fgnievinski/mphw/docs/poster_pre_revisao7b.pdf

Manuella Anaís Rodrigues Fagundes ¹ and Felipe Geremia Nievinski

1,2

1 Postgraduate Program on Remote Sensing, State Research Center for Remote Sensing and Meteorology, Federal University of Rio Grande do Sul, Brazil 2 Department of Geodesy, Institute of Geosciences, Federal University of Rio Grande do Sul, Brazil manuella.fagundes@ufrgs.br;felipe.nievinski@ufrgs.br
1. Introduction | 2. Materials and methods

## 3. Field validation

# Open-source hardware options for SNR-based GPS/GNSS reflectometry – Proof-of-concept and initial validation

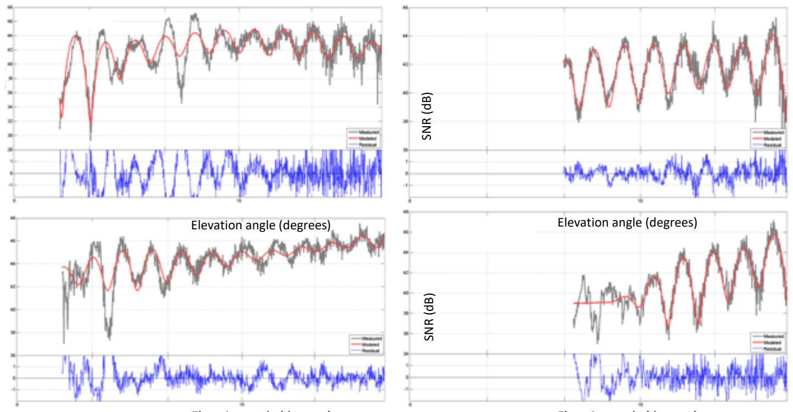
[picture p2: figure]
Elevation angle degree; SNR (dB) SNR (dB)

### 3.1 Location

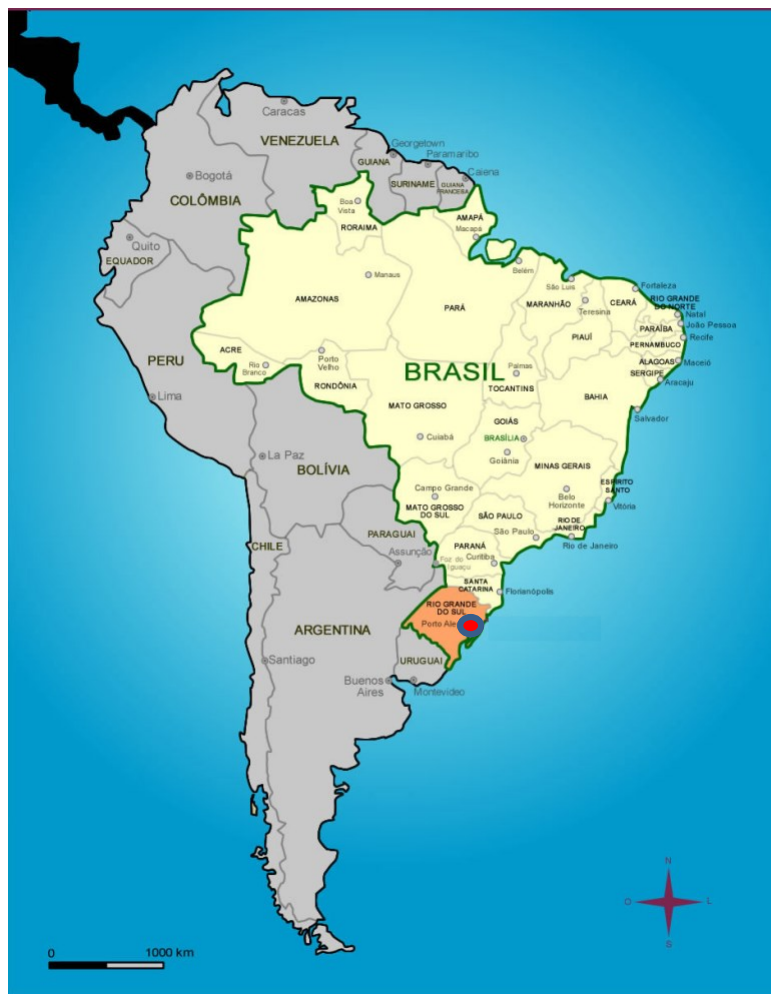
[picture p3: figure]
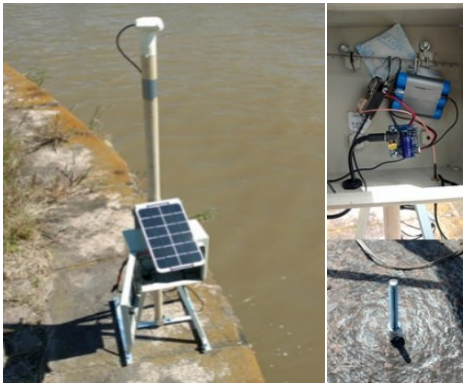
[picture p4: figure]
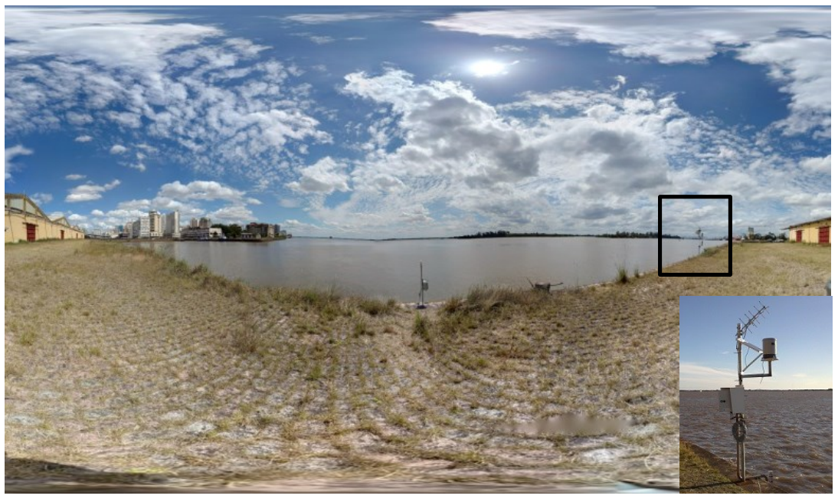
[picture p5: figure]
Figure 12: Localization
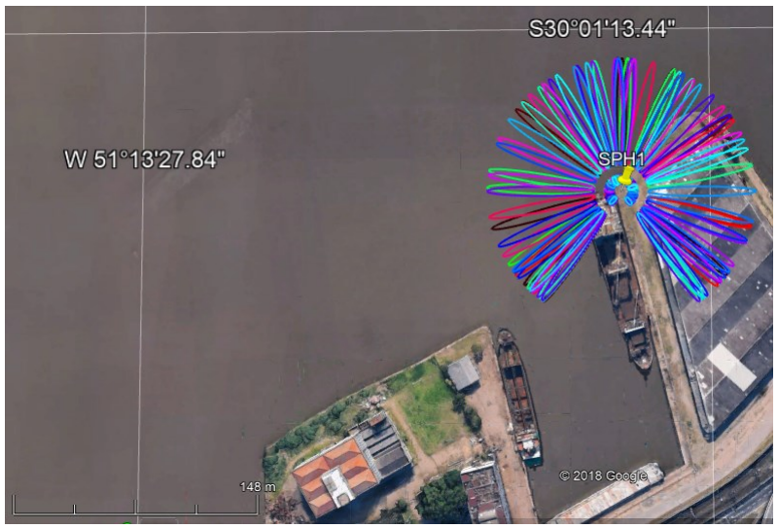
[picture p6: figure]
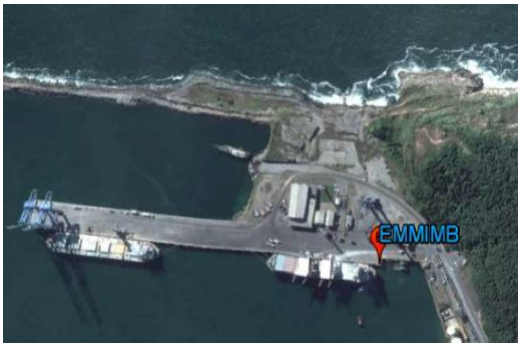
[picture p7: figure]
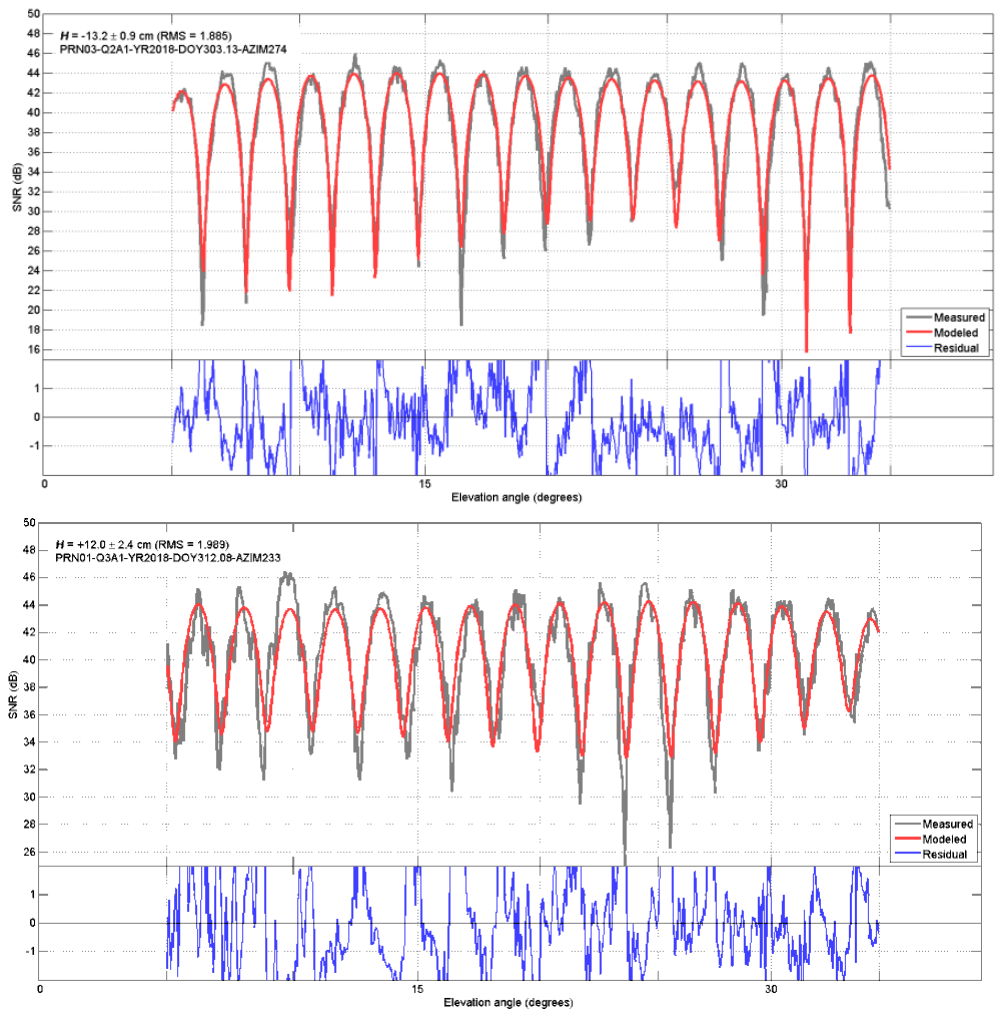
[picture p8: figure]

IEEE GNSS+R 2019 – Specialist Meeting on Reflectometry using GNSS and other Signals of Opportunity ∙ 20-22 May 2019, Benevento, Italy.

The | main | electronic | components
employed are shown in Figure 7: an Arduino board integrated with SD card
reader/writer | (Adafruit | Feather
Adalogger), a single-frequency GPS L1 C/A add-on (Adafruit GPS FeatherWing), and an external GPS antenna (active 28-dB, Chang Hong GPS-01-174-1M-0102). A complete solar power system was also developed (Figure 8).

Figure 7: Main sensor components: Arduino device with integrated SD-card interface (left); GPS shield with internal GPS antenna (middle); external antenna (right).

Figure 8: Solar power system: solar panel (far left); solar charge (center left); battery (center right); thermistor (far
right).

The total cost is US$205 as of January 2019; the complete bill of materials is publicly available at: http://www.adafruit.com/wishlists/469752

2.1 Hardware | 2.2 Software

We have developed two pieces of software, both available as open source. One piece runs onboard the Arduino and another runs in Matlab on a PC. They can be download from GitHub, at https://git.io/fjCnp.

Acknowledgements:

Figure 9: Sample SNR data in NMEA format.

On October 26th
, 2018 a unit was installed at the Mauá Wharf by the Guaíba River in the city of Porto Alegre, Brazil (30.0277°S, 51.2287°W), shown in Figures 11 and 12.

### 3.2 Installation

## 4. Initial results

We performed
inversion for the
estimation of the
water surface
height at the Mauá
Wharf applied to
several satellite
tracks (Figure 15).

Parameter estimates for the six satellite tracks shown resulted in a mean reflector height of 3.191 m with a standard deviation of 20 cm. For validation, we surveyed the water level and the antenna phase center, resulting in an average of 3.128 m with standard deviation of 2.4 cm, mainly caused by the small waves. The discrepancy of 6.3 cm amounts to approximately 2% of the reflector height.

Figure 1: Rising sea leve (left) and consequences (right).

Figure 2: Satellite altimeres (left) and tide gauge with GNSS.

Figure 3: Principles of the GNSS-R technique.

Figure 4: Applications of GNSS-R .

Figure 5: Geodetic equipment. | Figure 6: Experimental device.

Figure 10: Skyplot (left) and pattern of interference fringes (right)

Figure 13: GNSS-R experimental station.

Figure 14: Reflection Fresnel zones for elevation angles between 5° – 30° and antenna height equal to 3 m.

Figure 15: Inversion results: measurements are in gray, model fit in red, and residuals in blue (bottom panels).

Monitoring the sea level is fundamental due to climate change (Figure 1). Unfortunately, satellite altimeters do not work well in coastal regions and tide gauges are not as numerous as necessary and may be affected by vertical land motion (Figure 2).

Ground-based GNSS Reflectometry allows geocentric sea-level sensing (Figures 3 and 4). Geodetic-quality receivers and antennas are expensive; here, a lower-cost and open-source hardware alternative is presented (Figures 5 and 6).

Figure 12: Site panoramic view; inset: existing tide gauge.

Our GNSS-R station has been running uninterruptedly for more than six months (Figure 13).

## 5. Ongoing and future work

This research is funded by CNPq (457530/2014-6) and Fapergs (26228.414.42497.26062017).

MF acknowledges CAPES for a scholarship and IEEE for a travel grant.

Elevation angle (degrees)

Elevation angle (degrees)

Elevation angle (degrees) | Elevation angle (degrees)

We are in the process of analyzing several months of data collected since installation.

We | are | also | planning | an
installation by the sea, at the Imbituba Port (Santa Catarina state), where several tide gauges exist.

Figure 11: Map indicating the site location (red dot).

Figure 17: Location of future sea-facing installation.

Figure 16: Sample SNR results from river-facing site.
