fgnievinski/mphw/code/matlab/battery/battery_example.png

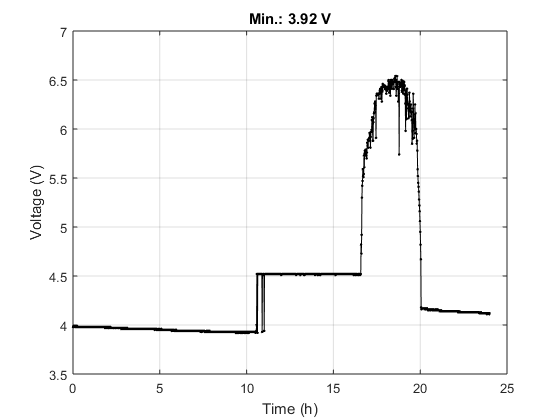
code/matlab/battery/battery_example.png
