fgnievinski/mphw/code/matlab/demo/PRN03.png

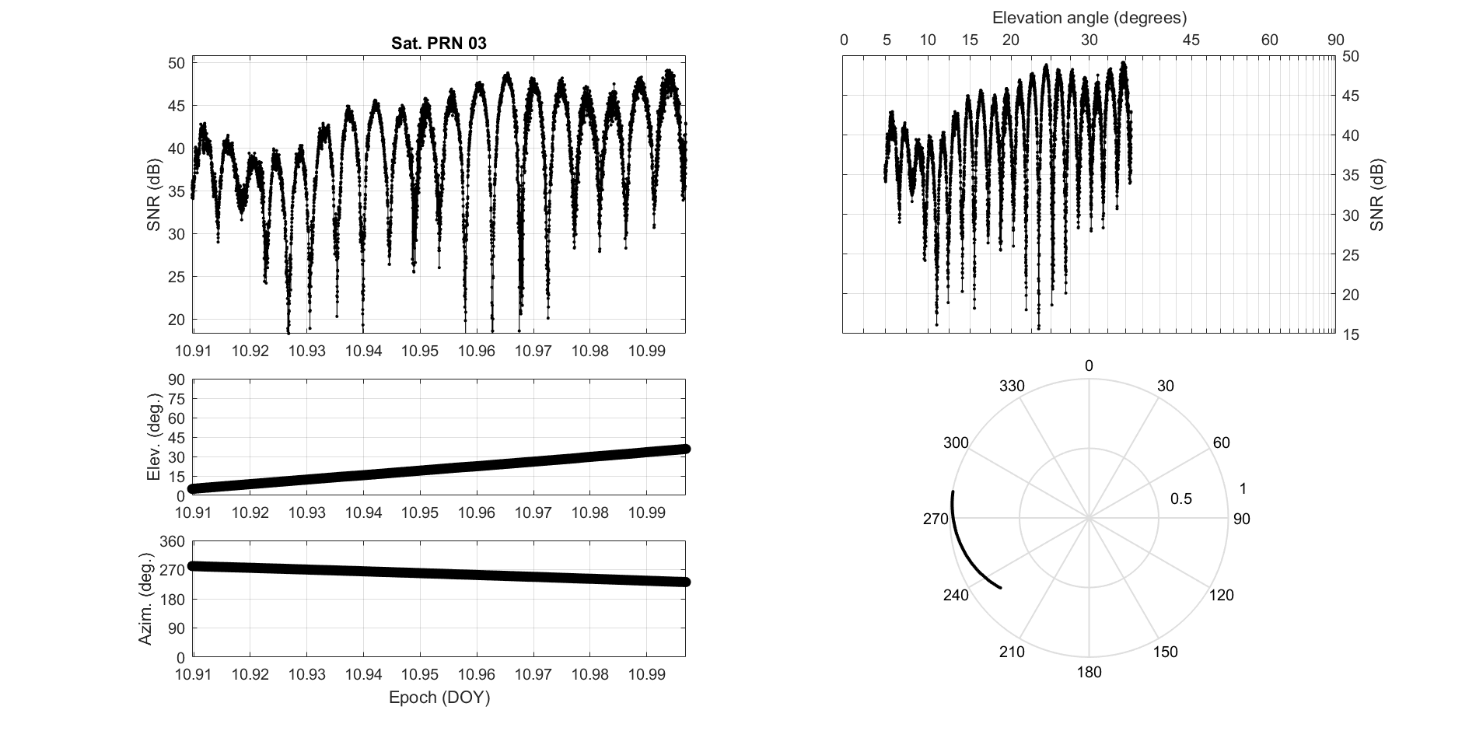
code/matlab/demo/PRN03.png
