fgnievinski/mphw/code/matlab/demo/PRN05-zoom.png

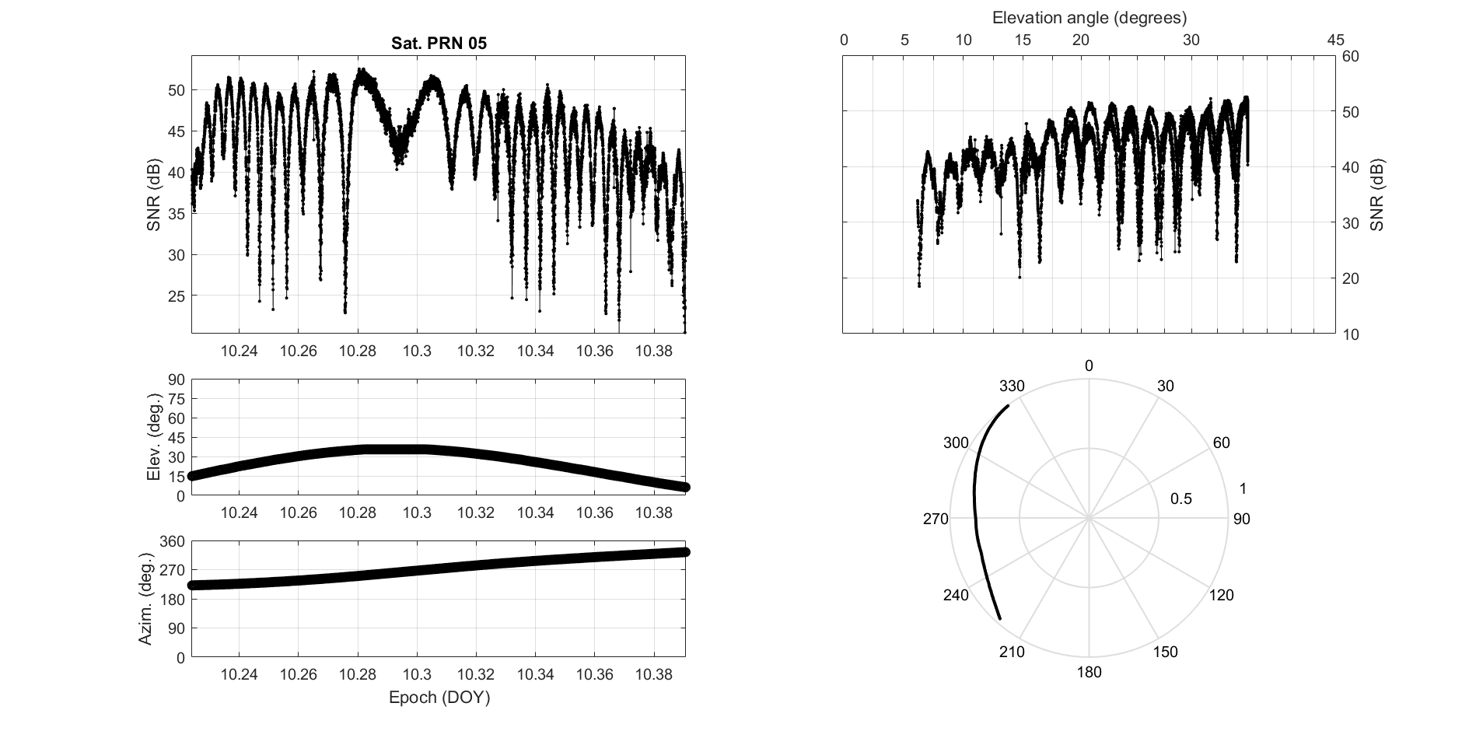
code/matlab/demo/PRN05-zoom.png
