fgnievinski/mphw/(threads)

Thread 2 (2020-10-06):

[Alta] Versão 2 do GPS logger

gdsantana, 2020-10-06:
- [ ] [Baixa] Implementar suporte a arquivo de configuração e mover as opções do usuário de fora do codigo:
usar a seguinte biblioteca:

https://www.arduinolibraries.info/libraries/ini-file

Backup do histórico do CTA:
[estacao-maregrafica-562.pdf](https://github.com/fgnievinski/mphw/files/5334042/estacao-maregrafica-562.pdf)

gdsantana, 2020-10-06:
- [ ] [Normal] Criar versão especial para altas taxas usando gravação imediata, direto do GPS para o cartão, sem intermédio de buffer

Closed 2020-10-06.

Thread 3 (2020-10-06):

[Normal] Varinha

gdsantana, 2020-10-06:
- [X] Versão 0:
conectar receptor  GPS no PC com cabo serial.
http://navspark.mybigcommerce.com/content/NavSpark-User-Guide_rev0.9.pdf

gdsantana, 2020-10-06:
- [ ] Versão 1: Analisar dados do mecanismo motorizado

Os dados obtidos em um levantamento com antena motorizada no campus da UNESP foi analisado e processado.
Os resultados foram publicados em um artigo para o Congresso Aeroespacial Brasileiro.

Embora este experimento tenha sido realizado em condições desfavoráveis para refletometria (tempo de rastreio curto e horizonte encoberto), foi possível obter resultados consistentes para alguns satélites observados.

Satélite Refletometria (m) Topografia (m) Diferença (m)
R 02 1,335 1,412 -0,077
R 24 1,455 1,570 -0,115
[Matriz_vertical_de_sensores_cmplt_V1.pdf](https://github.com/fgnievinski/mphw/files/5334400/Matriz_vertical_de_sensores_cmplt_V1.pdf)

Um novo levantamento com a versão motorizada foi realizado no terreno do Colégio Aplicação da UFRGS. Este novo levantamento possui um intervalo temporal de dados maior.
Já que o levantamento foi realizado em uma quadra de esportes em céu aberto, foi possível considerar a altura medida como um valor constante.
Este levantamento foi realizado com o receptor NETRS.
Neste levantamento foi constatado que, com a antena utilizada não é possível medir refletometria em satélites com ângulo de elevação alto devido aos filtros presentes nas antenas de receptores geodésicos.

Satellit Satellite_elevation Reflectometry_height Measured_height Error
G 09 19.9º 1.58 m 1.497 m 0.283 m
G 19 13.4º 1.67 m 1.497 m 0.133 m
[vertical_array_GNSSR_CAP (1).pdf](https://github.com/fgnievinski/mphw/files/5334401/vertical_array_GNSSR_CAP.1.pdf)

gdsantana, 2020-10-06:
- [ ] Versão 2: Com uso do MatLab e biblioteca disponibilizada, simular medição refletométrica com um receptor em movimento cíclico vertical.

A simulação foi realizada com condições semelhantes a experimento realizado anteriormente com um receptor geodésico de dupla frequência acoplado a motor que realizou movimento vertical cíclico de 1Hz

Closed 2020-10-06.
